chirags98/Project_Alpha/PCB/Schematic.pdf

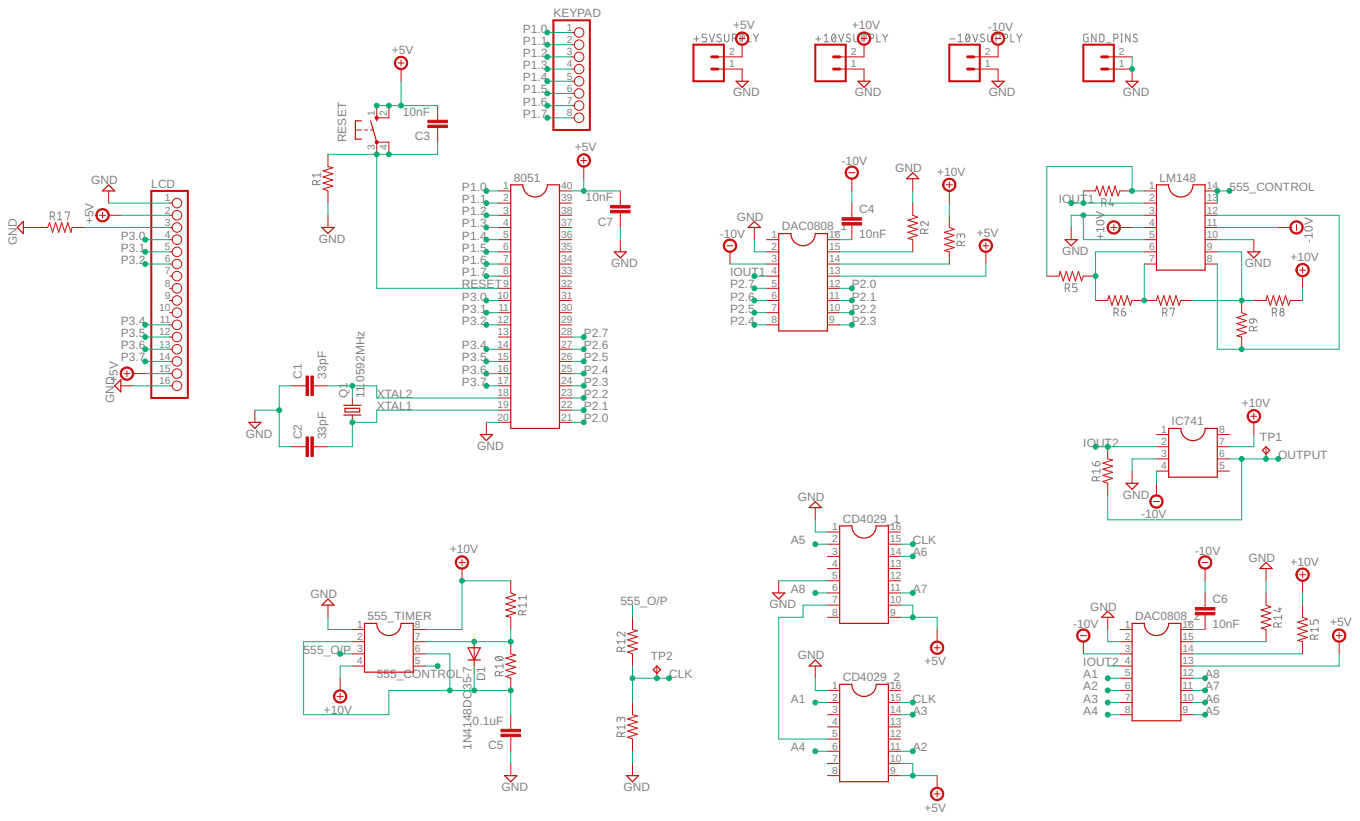
[picture p1: page 1]

SpiceOrder 1 SpiceOrder 2 11.0592MHz 33pF 33pF GND GND GND +5V +5V 10nF +5V +10V -10V GND GND 10nF -10V GND +10V -10V GND +10V +10V0.1uF 1N4148DO35-7 GND GND GND +5V +10V -10V GND GND 10nF -10V +5V +5V GND GND GND -10V +10V GND GNDGND+5V +5V GND GND GND GND +5V +10V -10V GND +10V 10nFGND 8051 1234567891011121314151617181920 2122232425262728293031323334353637383940 Q1 C1 C2 RESET 3 12 4 DAC0808_1 12345678 910111213141516 C3 C4 LM148 1234567 891011121314 555_TIMER 1234 5678 C5 D1 CD4029_1 12345678 910111213141516 CD4029_2 12345678 910111213141516 DAC0808_2 12345678 910111213141516 C6 IC741 1234 5678 LCD12345678910111213141516 KEYPAD 12345678 12 12 12 TP1 12 TP2 C7 XTAL2 XTAL1 RESET P2.0 P2.0 P2.1 P2.1 P2.2 P2.2 P2.3 P2.3 P2.4 P2.4 P2.5 P2.5 P2.6 P2.6 P2.7 P2.7 555_CONTROL 555_CONTROL 555_O/P 555_O/PCLK CLK CLK IOUT1 IOUT1IOUT2 IOUT2 A1 A1 A2 A2 A3 A3 A4 A4 A5 A5 A6 A6 A7 A7 A8 A8 OUTPUT P3.0 P3.0 P3.1 P3.1 P3.2 P3.2 P3.4 P3.4 P3.5 P3.5 P3.6 P3.6 P3.7 P3.7 P1.0 P1.0 P1.1 P1.1 P1.2 P1.2 P1.3 P1.3 P1.4 P1.4 P1.5 P1.5 P1.6 P1.6 P1.7 P1.7
