chirags98/Project_Alpha/PCB/Board.pdf

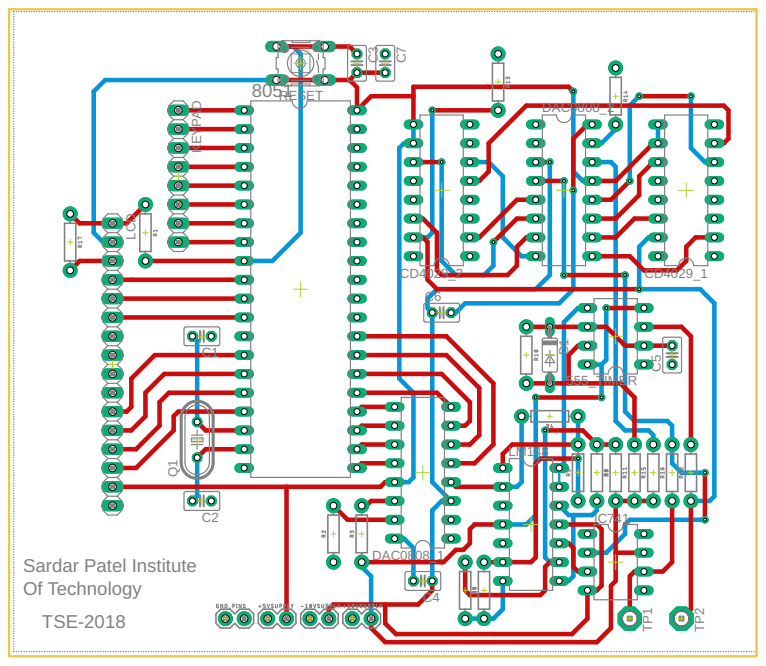
[picture p2: page 1]
