chirags98/Project_Alpha/(list of files, drawings)

Other design files:
final2018tsc.pdsprj
