chirags98/Project_Alpha/PCB/PCB.brd

## EAGLE design PCB/PCB.brd (2018-10-18)

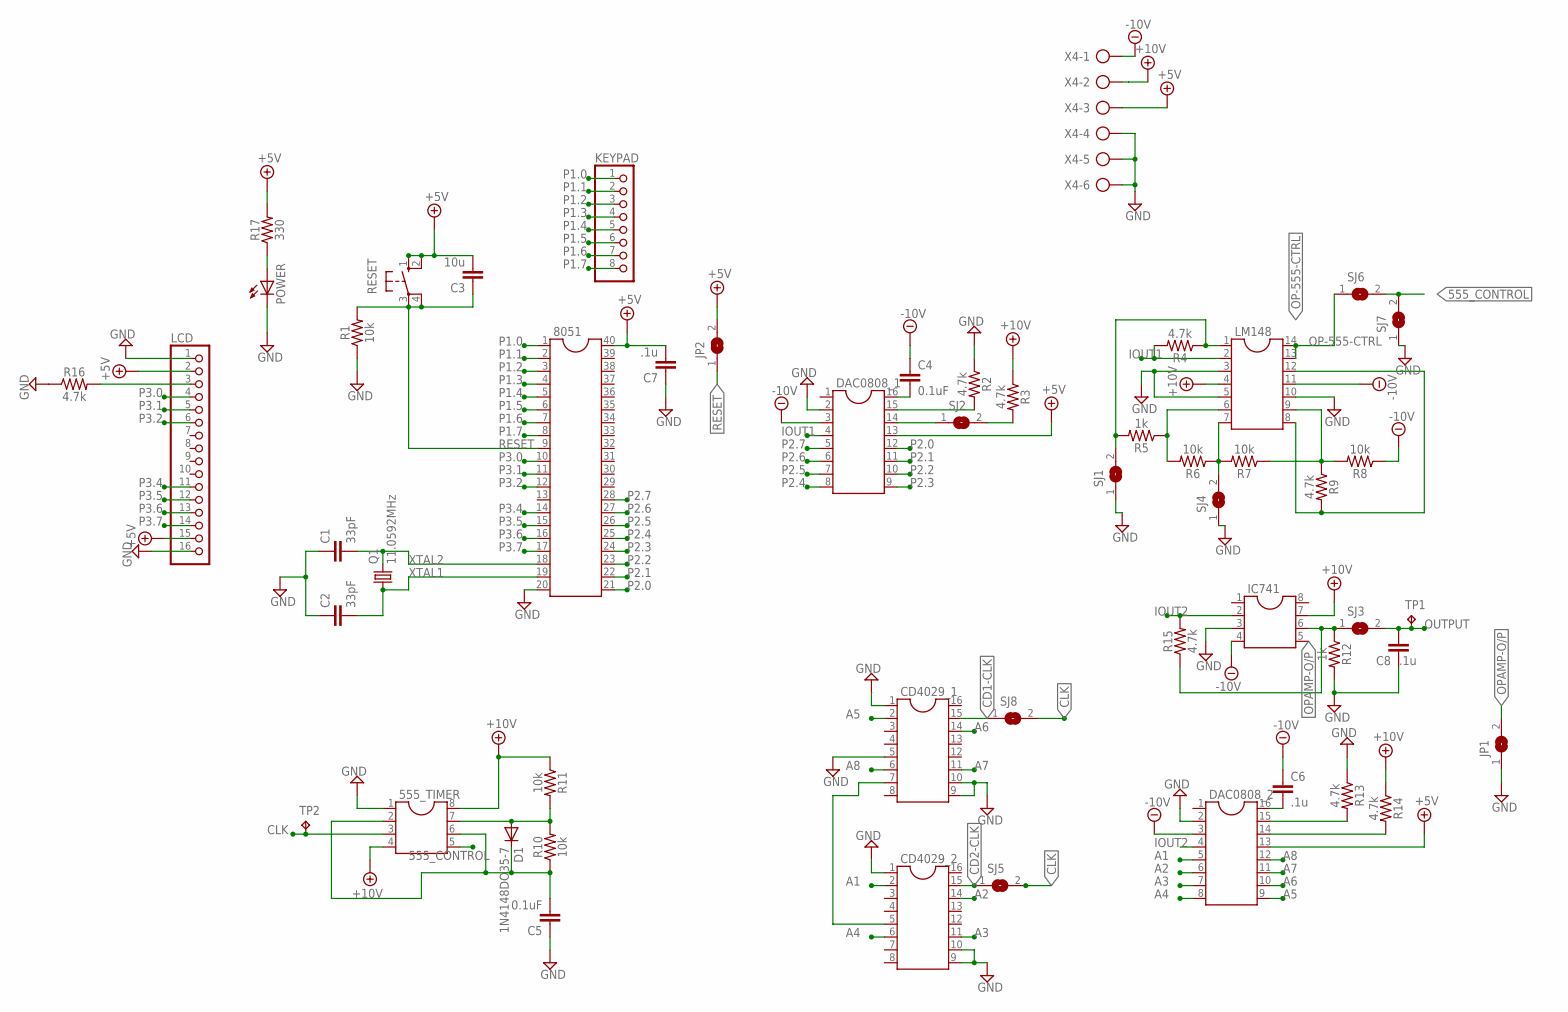
[picture p3: schematic PCB.sch]

Parts:
555_TIMER: DIL8; DIL08
8051: DIL40; MPN PIC-USB-4550
C1, C2: 33pF; C025-025X050
C3: 10u; C025-025X050
C4, C5: 0.1uF; C025-025X050
C6, C7, C8: .1u; C025-025X050
CD4029_1, CD4029_2: DIL16
D1: 1N4148DO35-7; DO35-7
DAC0808_1, DAC0808_2: DIL16
IC741: DIL8; DIL08
JP1, JP2: SJ
KEYPAD: PINHD-1X8; 1X08
LCD: PINHD-1X16; 1X16
LM148: DIL14
POWER: LED5MM
Q1: 11.0592MHz; HC49/S; MPN HC49SM-3.6864-30-50-60-16-ATF
R1, R6, R7, R8, R10, R11: 10k; AXIAL-0.3
R2, R3, R4, R9, R13, R14, R15, R16: 4.7k; AXIAL-0.3
R5, R12: 1k; AXIAL-0.3
R17: 330; AXIAL-0.3
RESET: 10-XX; B3F-10XX
SJ1, SJ2, SJ3, SJ4, SJ5, SJ6, SJ7, SJ8: SJ
TP1, TP2: TPPAD1-20; P1-20
X4: AK500/6-H

Connections:
555_CONTROL: 555_TIMER.5, SJ6.2, SJ7.2
+5V: 8051.40, C3.2, C7.2, DAC0808_1.13, DAC0808_2.13, JP2.2, LCD.2, LCD.15, R17.P$2 (2), RESET.1 (S), RESET.2 (S1), X4.3
+10V: 555_TIMER.4, 555_TIMER.8, IC741.7, LM148.4, R3.P$1 (1), R11.P$1 (1), R14.P$1 (1), X4.2
-10V: C4.1, C6.1, DAC0808_1.3, DAC0808_2.3, IC741.4, LM148.11, R8.P$1 (1), X4.1
A1: CD4029_2.2, DAC0808_2.5
A2: CD4029_2.14, DAC0808_2.6
A3: CD4029_2.11, DAC0808_2.7
A4: CD4029_2.6, DAC0808_2.8
A5: CD4029_1.2, DAC0808_2.9
A6: CD4029_1.14, DAC0808_2.10
A7: CD4029_1.11, DAC0808_2.11
A8: CD4029_1.6, DAC0808_2.12
CD1-CLK: CD4029_1.15, SJ8.1
CD2-CLK: CD4029_2.15, SJ5.1
CLK: 555_TIMER.3, SJ5.2, SJ8.2, TP2.TP
GND: 555_TIMER.1, 8051.20, C1.1, C2.1, C5.1, C7.1, C8.1, CD4029_1.1, CD4029_1.5, CD4029_1.9, CD4029_1.10, CD4029_2.1, CD4029_2.9, CD4029_2.10, DAC0808_1.2, DAC0808_2.2, IC741.3, JP1.1, LCD.1, LCD.16, LM148.3, LM148.5, LM148.10, POWER.K (C), R1.P$1 (1), R2.P$1 (1), R12.P$2 (2), R13.P$1 (1), R16.P$1 (1), SJ1.1, SJ4.1, SJ7.1, X4.4, X4.5, X4.6
IOUT1: DAC0808_1.4, LM148.2, R4.P$2 (2)
IOUT2: DAC0808_2.4, IC741.2, R15.P$2 (2)
unnamed: DAC0808_1.15, R2.P$2 (2)
unnamed: R3.P$2 (2), SJ2.2
unnamed: C4.2, DAC0808_1.16
unnamed: LM148.7, R6.P$1 (1), R7.P$2 (2), SJ4.2
unnamed: LM148.1, R4.P$1 (1), R5.P$2 (2), SJ1.2
unnamed: LM148.6, R5.P$1 (1), R6.P$2 (2)
unnamed: LM148.9, R7.P$1 (1), R8.P$2 (2), R9.P$1 (1)
unnamed: 555_TIMER.7, D1.A, R10.P$2 (2), R11.P$2 (2)
unnamed: 555_TIMER.2, 555_TIMER.6, C5.2, D1.C, R10.P$1 (1)
unnamed: DAC0808_2.15, R13.P$2 (2)
unnamed: DAC0808_2.14, R14.P$2 (2)
unnamed: C6.2, DAC0808_2.16
unnamed: CD4029_1.7, CD4029_2.5
unnamed: POWER.A, R17.P$1 (1)
unnamed: DAC0808_1.14, SJ2.1
unnamed: LM148.8, LM148.12, R9.P$2 (2)
unnamed: LCD.3, R16.P$2 (2)
OP-555-CTRL: LM148.13, LM148.14, SJ6.1
OPAMP-O/P: IC741.6, JP1.2, R12.P$1 (1), R15.P$1 (1), SJ3.1
OUTPUT: C8.2, SJ3.2, TP1.TP
P1.0: 8051.1, KEYPAD.1
P1.1: 8051.2, KEYPAD.2
P1.2: 8051.3, KEYPAD.3
P1.3: 8051.4, KEYPAD.4
P1.4: 8051.5, KEYPAD.5
P1.5: 8051.6, KEYPAD.6
P1.6: 8051.7, KEYPAD.7
P1.7: 8051.8, KEYPAD.8
P2.0: 8051.21, DAC0808_1.12
P2.1: 8051.22, DAC0808_1.11
P2.2: 8051.23, DAC0808_1.10
P2.3: 8051.24, DAC0808_1.9
P2.4: 8051.25, DAC0808_1.8
P2.5: 8051.26, DAC0808_1.7
P2.6: 8051.27, DAC0808_1.6
P2.7: 8051.28, DAC0808_1.5
P3.0: 8051.10, LCD.4
P3.1: 8051.11, LCD.5
P3.2: 8051.12, LCD.6
P3.4: 8051.14, LCD.11
P3.5: 8051.15, LCD.12
P3.6: 8051.16, LCD.13
P3.7: 8051.17, LCD.14
RESET: 8051.9, C3.1, JP2.1, R1.P$2 (2), RESET.3, RESET.4 (P1)
XTAL1: 8051.19, C2.2, Q1.1
XTAL2: 8051.18, C1.2, Q1.2

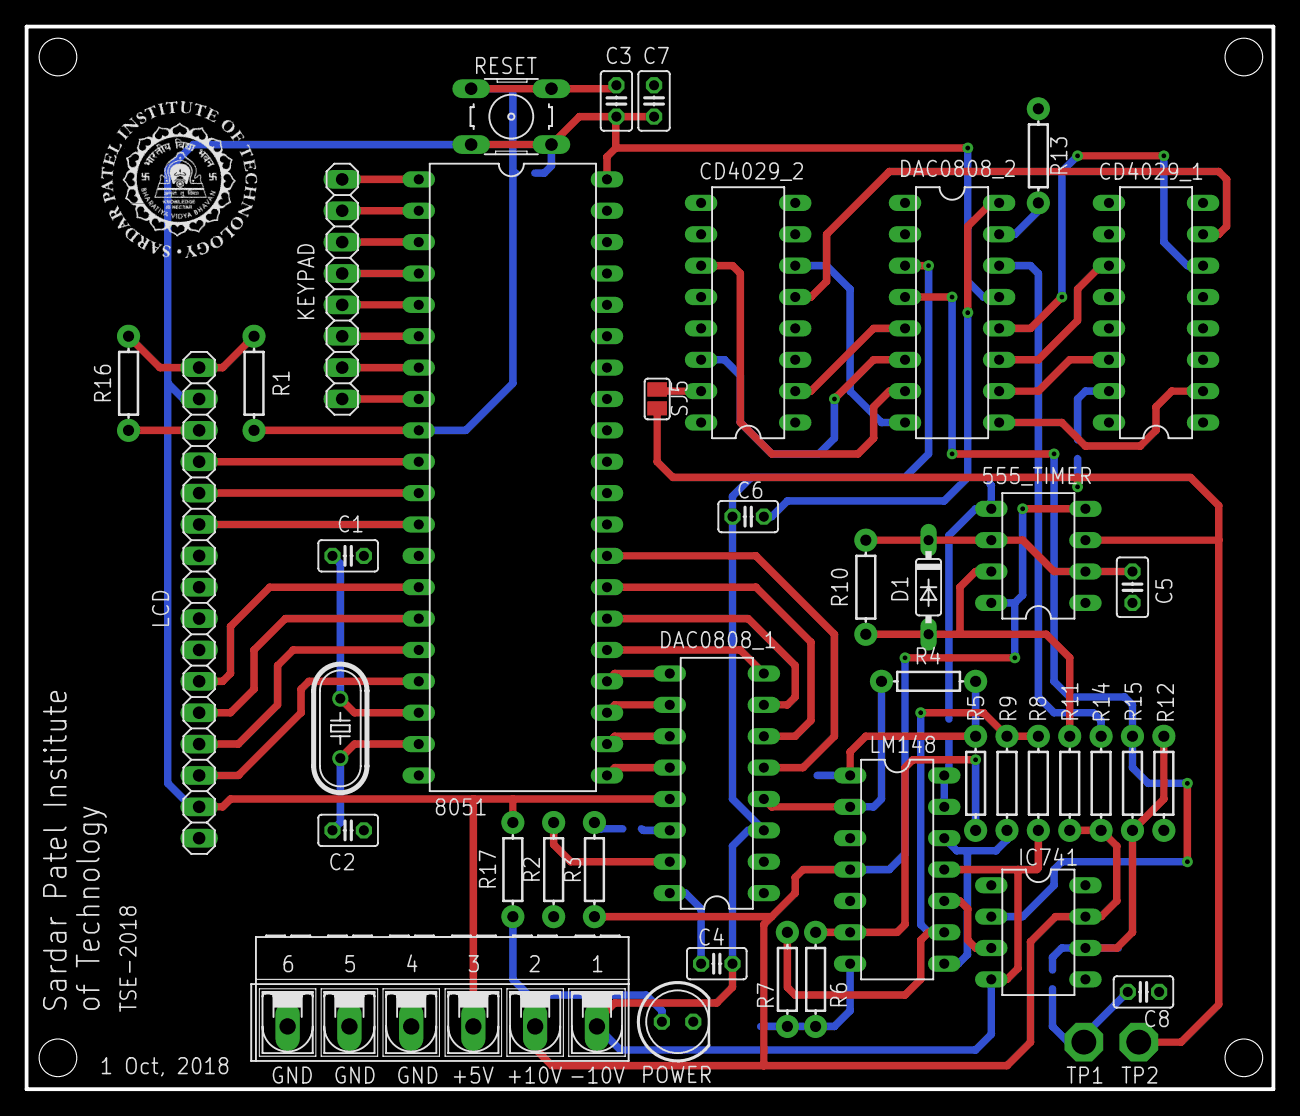
[picture p4: board PCB.brd from above]

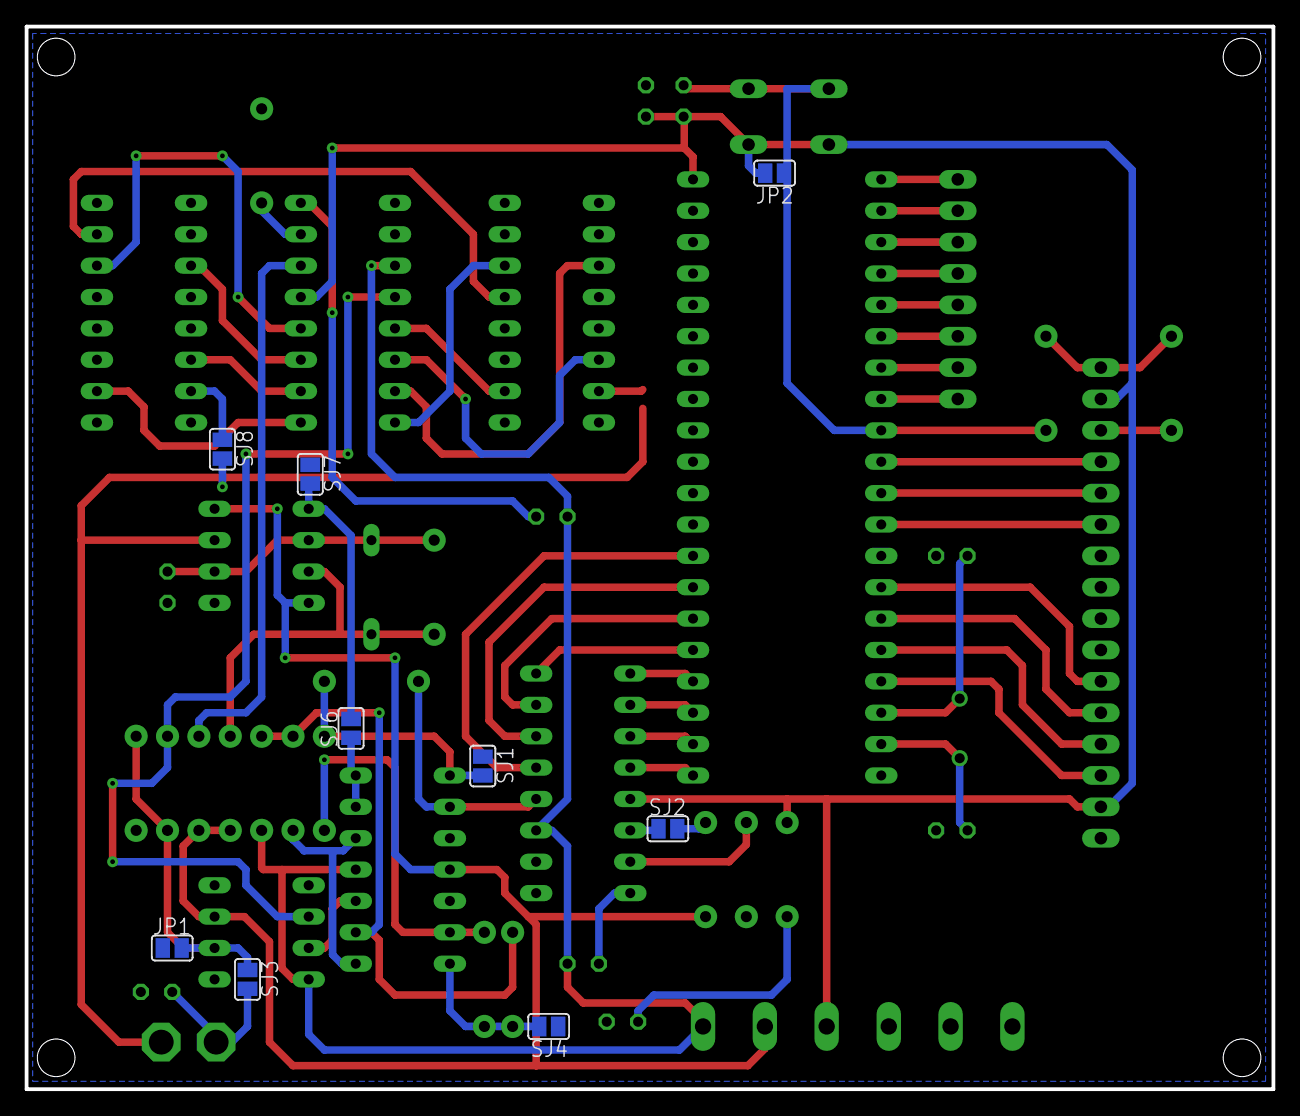
[picture p5: board PCB.brd from below]

Board: 2 copper layers, 100.9 x 86.0 mm, 52 parts (9 on the bottom side), 64 nets.
