chirags98/Project_Alpha/(commit log)

2018-09-15 Added board after initial routing
    [PCB.brd, PCB.sch]
2018-09-16 Add files via upload
    Changes made:
    1) Changed supply to R8 (from -10V to +10V).
    2) Increased all track widths from 10 mil to 24 mil.
    3) Added a bypass capacitor for 8051.
    4) Shifted GND plane to bottom layer and gave isolation setting of 16 mil.
2018-09-20 Add files via upload
    Proteus Simulation
    [final2018tsc.pdsprj]
2018-09-30 PCB Verified
    Changes done:
    1) Supply and resistor value change in Adder Subtractor circuit.
    2)No more potential divider from 555 output.
    3)Correction in Counter 2 circuit(Pins 14 and 11 were given to wrong outputs)
    4)Final output resistor included(R12)
    5)All final values added to schematic.
    6)UP/DN' and BIN/DEC' pins on Counters(Pins 9 and 10) need to be pulled downed to GND instead of pulled up to VCC.
2018-09-30 Added adithya's files after verification
    [PCB.brd, PCB.sch]
2018-09-30 Silkscreen, mounting holes, power/ip screw terminals
    [PCB.brd, PCB.sch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]
2018-10-01 Final-for manufacturing
    [PCB.brd, PCB.sch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]
2018-10-10 Commit since not sure if any changes are made
    [PCB.brd, PCB.sch]
2018-10-18 During assembly - changed some values
    [PCB.brd, PCB.sch]
